Martin78b/AquaSense/riego/secrets.example.h

// Copiá este archivo como secrets.h (en esta misma carpeta) y completá tu red.
// secrets.h está en .gitignore, así que tus claves no se suben al repositorio.
#pragma once

#define WIFI_SSID "TU_RED"
#define WIFI_PASS "TU_CLAVE"
