Martin78b/AquaSense/(commit log)

2026-10-17 feat: initial commit with modular ESP32 automatic irrigation system, local web server, and Telegram integration
2026-10-23 docs: add wiring documentation and HTML schematic for multi-source USB power setup
2026-10-29 feat: add parametric 3D enclosure for AquaSense breakout shield and complog JSON
    [carcasa_aquasense.scad]
2026-11-03 docs: update wiring to connect pump positives directly to +5V source and update README
2026-11-03 docs: update sensor documentation and references from v1.2 to V2.0.0 TLC555
2026-11-06 docs: document GPIO 14 wiring for XKC-Y25-NPN water level sensor
